LeoAndGit/dSIB_daVinci_setup_joint_interface_board/PCB/daVinciBoard-01.pdf

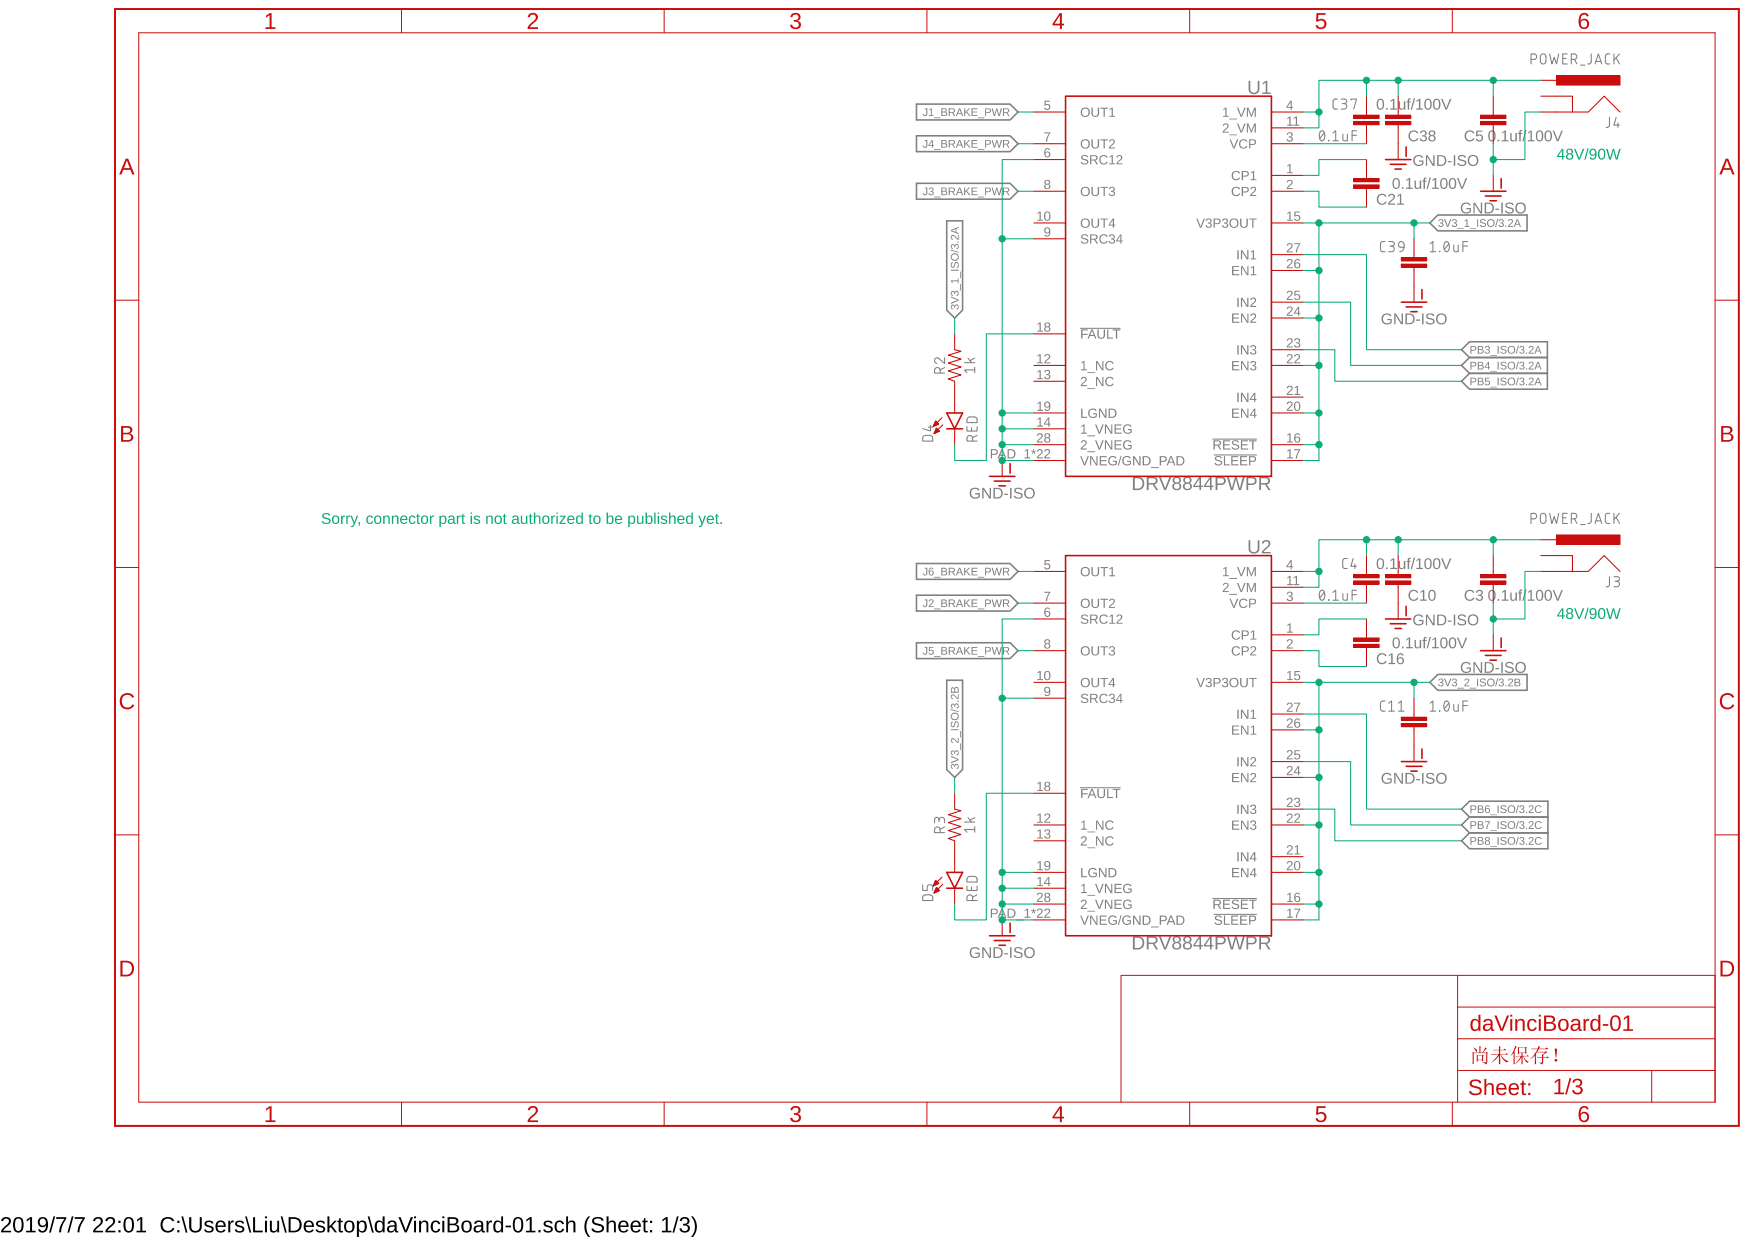
[picture p5: page 1]

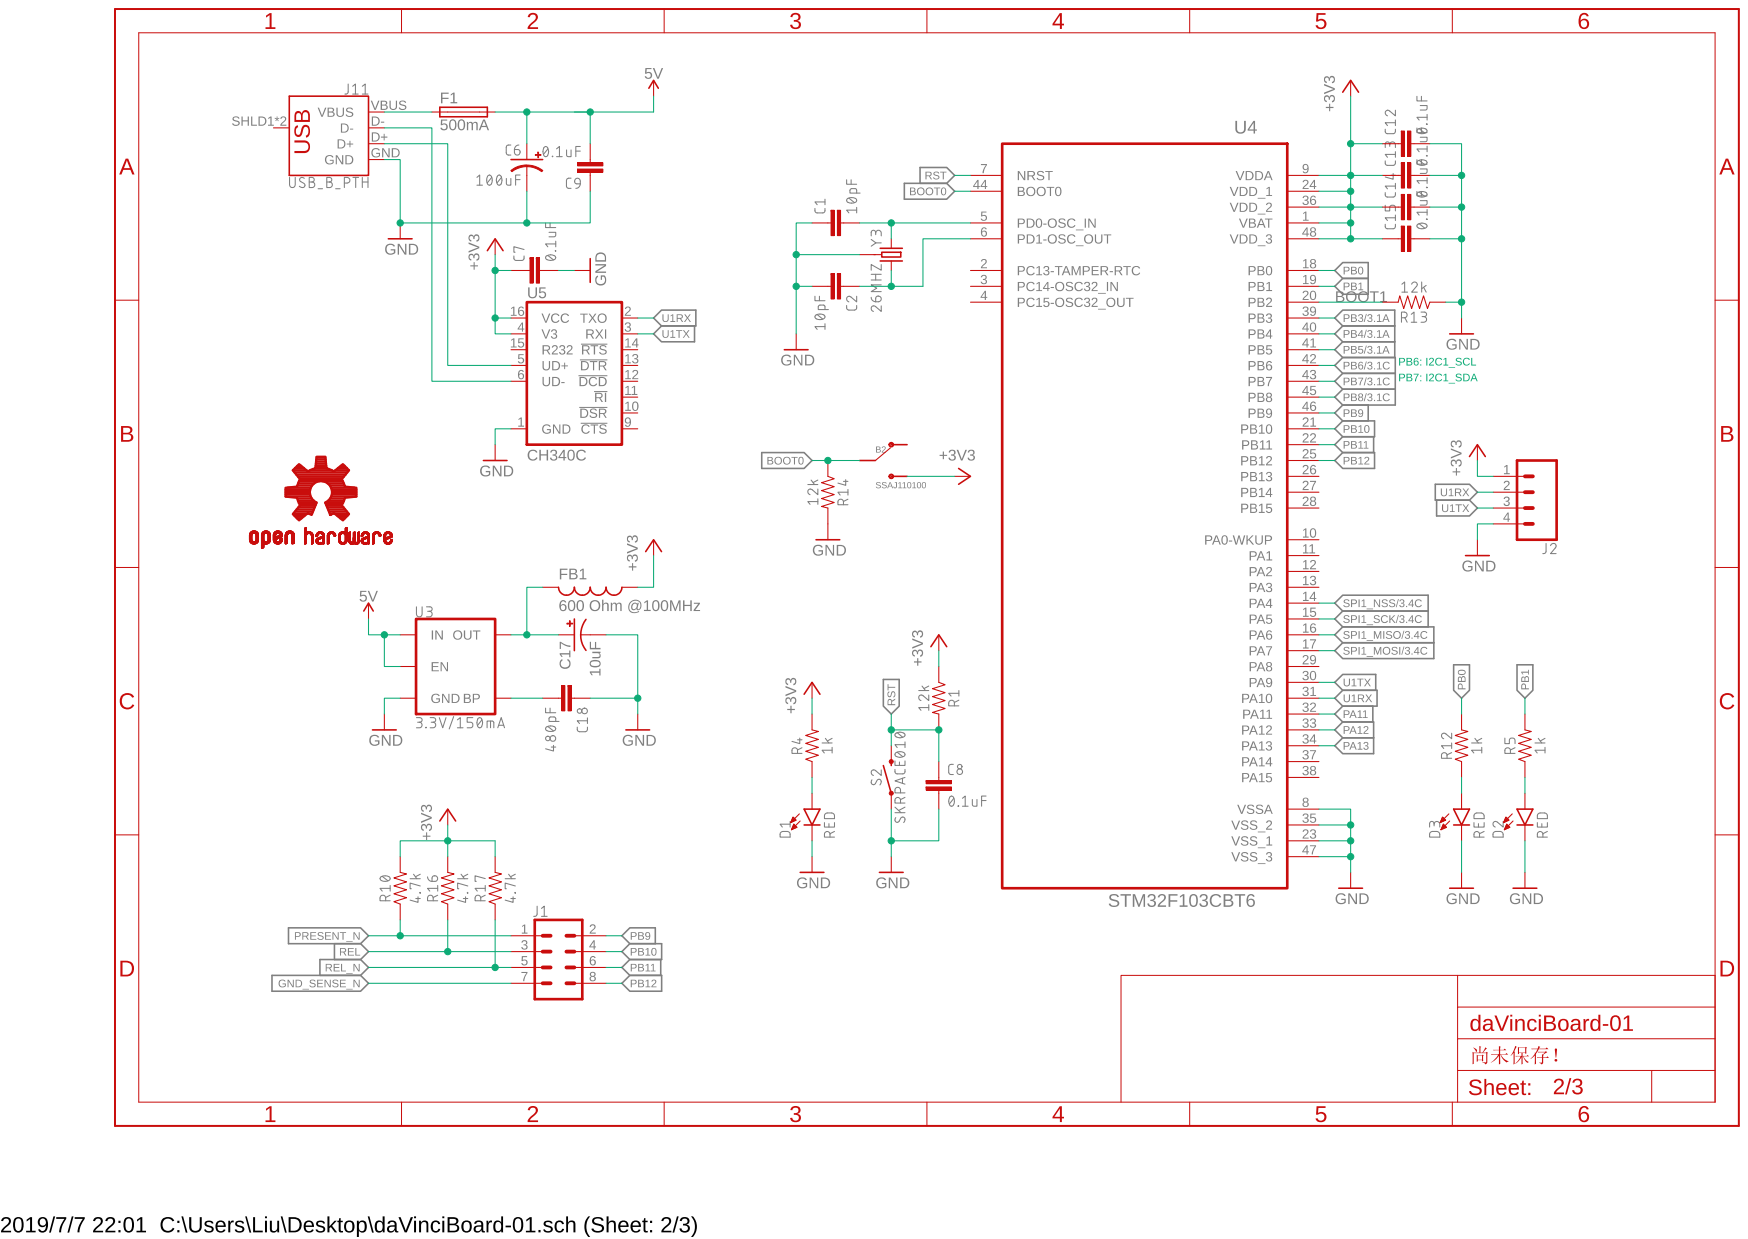
[picture p6: page 2]

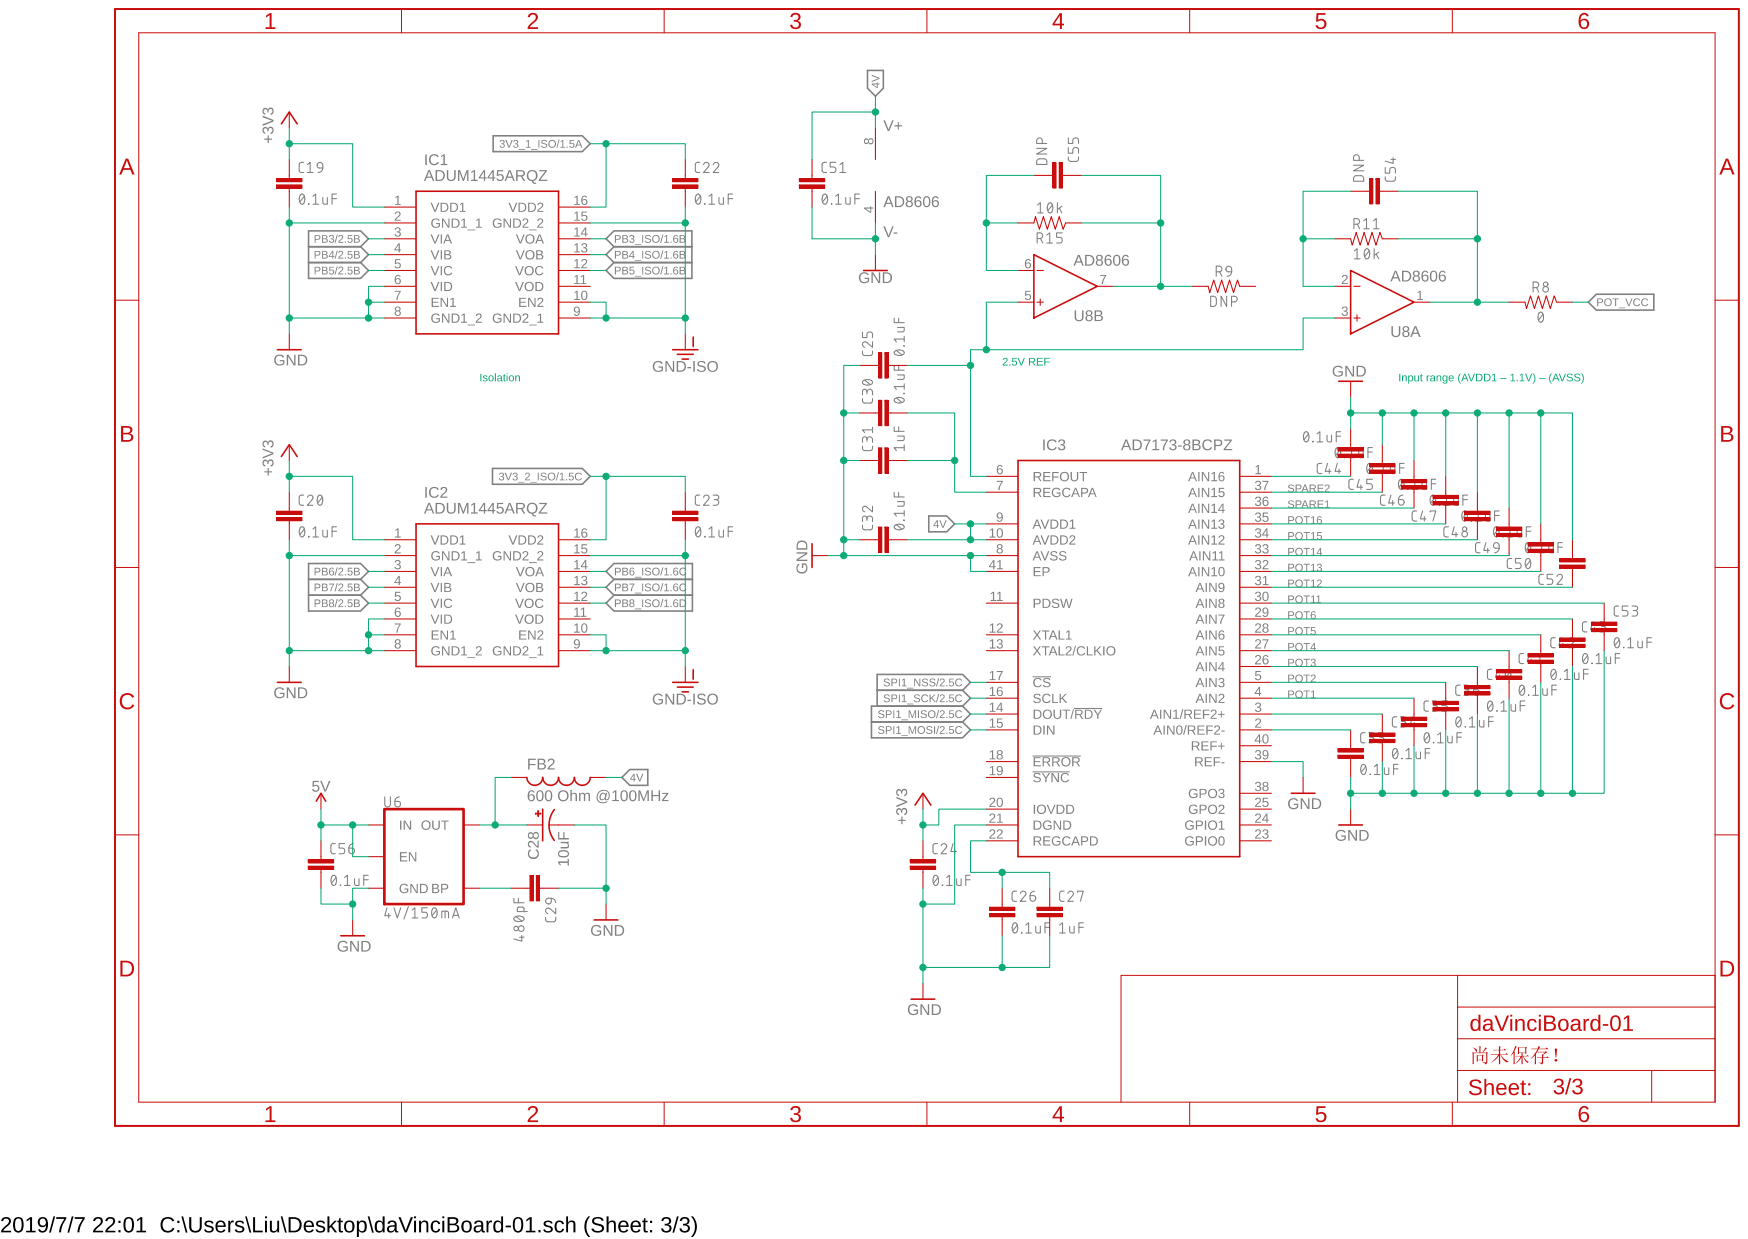
[picture p7: page 3]
