LeoAndGit/dSIB_daVinci_setup_joint_interface_board/code/python/mainUI.py

# -*- coding: utf-8 -*-

# Form implementation generated from reading ui file 'mainUI.ui'
#
# Created by: PyQt5 UI code generator 5.9.2
#
# WARNING! All changes made in this file will be lost!

from PyQt5 import QtCore, QtGui, QtWidgets

class Ui_Form(object):
    def setupUi(self, Form):
        Form.setObjectName("Form")
        Form.setEnabled(True)
        Form.resize(678, 595)
        Form.setContextMenuPolicy(QtCore.Qt.DefaultContextMenu)
        self.horizontalLayout_3 = QtWidgets.QHBoxLayout(Form)
        self.horizontalLayout_3.setObjectName("horizontalLayout_3")
        self.verticalLayout = QtWidgets.QVBoxLayout()
        self.verticalLayout.setObjectName("verticalLayout")
        self.horizontalLayout = QtWidgets.QHBoxLayout()
        self.horizontalLayout.setObjectName("horizontalLayout")
        self.link = QtWidgets.QPushButton(Form)
        sizePolicy = QtWidgets.QSizePolicy(QtWidgets.QSizePolicy.Minimum, QtWidgets.QSizePolicy.Minimum)
        sizePolicy.setHorizontalStretch(0)
        sizePolicy.setVerticalStretch(0)
        sizePolicy.setHeightForWidth(self.link.sizePolicy().hasHeightForWidth())
        self.link.setSizePolicy(sizePolicy)
        self.link.setObjectName("link")
        self.horizontalLayout.addWidget(self.link)
        self.start = QtWidgets.QPushButton(Form)
        sizePolicy = QtWidgets.QSizePolicy(QtWidgets.QSizePolicy.Minimum, QtWidgets.QSizePolicy.Minimum)
        sizePolicy.setHorizontalStretch(0)
        sizePolicy.setVerticalStretch(0)
        sizePolicy.setHeightForWidth(self.start.sizePolicy().hasHeightForWidth())
        self.start.setSizePolicy(sizePolicy)
        self.start.setObjectName("start")
        self.horizontalLayout.addWidget(self.start)
        self.stop = QtWidgets.QPushButton(Form)
        sizePolicy = QtWidgets.QSizePolicy(QtWidgets.QSizePolicy.Minimum, QtWidgets.QSizePolicy.Minimum)
        sizePolicy.setHorizontalStretch(0)
        sizePolicy.setVerticalStretch(0)
        sizePolicy.setHeightForWidth(self.stop.sizePolicy().hasHeightForWidth())
        self.stop.setSizePolicy(sizePolicy)
        self.stop.setStyleSheet("QPushButton { color: red }")
        self.stop.setObjectName("stop")
        self.horizontalLayout.addWidget(self.stop)
        self.verticalLayout.addLayout(self.horizontalLayout)
        self.textEdit = QtWidgets.QTextEdit(Form)
        self.textEdit.setEnabled(True)
        self.textEdit.setReadOnly(True)
        self.textEdit.setObjectName("textEdit")
        self.verticalLayout.addWidget(self.textEdit)
        self.verticalLayout.setStretch(0, 1)
        self.verticalLayout.setStretch(1, 6)
        self.horizontalLayout_3.addLayout(self.verticalLayout)
        self.verticalLayout_2 = QtWidgets.QVBoxLayout()
        self.verticalLayout_2.setObjectName("verticalLayout_2")
        self.gridLayout = QtWidgets.QGridLayout()
        self.gridLayout.setObjectName("gridLayout")
        self.lcdNumber_7 = QtWidgets.QLCDNumber(Form)
        self.lcdNumber_7.setObjectName("lcdNumber_7")
        self.gridLayout.addWidget(self.lcdNumber_7, 0, 2, 1, 1)
        self.label_4 = QtWidgets.QLabel(Form)
        self.label_4.setObjectName("label_4")
        self.gridLayout.addWidget(self.label_4, 2, 1, 1, 1)
        self.label_2 = QtWidgets.QLabel(Form)
        self.label_2.setObjectName("label_2")
        self.gridLayout.addWidget(self.label_2, 0, 3, 1, 1)
        self.label_10 = QtWidgets.QLabel(Form)
        self.label_10.setObjectName("label_10")
        self.gridLayout.addWidget(self.label_10, 3, 3, 1, 1)
        self.label_6 = QtWidgets.QLabel(Form)
        self.label_6.setObjectName("label_6")
        self.gridLayout.addWidget(self.label_6, 4, 1, 1, 1)
        self.label_9 = QtWidgets.QLabel(Form)
        self.label_9.setObjectName("label_9")
        self.gridLayout.addWidget(self.label_9, 2, 3, 1, 1)
        self.label_5 = QtWidgets.QLabel(Form)
        self.label_5.setObjectName("label_5")
        self.gridLayout.addWidget(self.label_5, 3, 1, 1, 1)
        self.label_11 = QtWidgets.QLabel(Form)
        self.label_11.setObjectName("label_11")
        self.gridLayout.addWidget(self.label_11, 4, 3, 1, 1)
        self.label_8 = QtWidgets.QLabel(Form)
        self.label_8.setObjectName("label_8")
        self.gridLayout.addWidget(self.label_8, 1, 3, 1, 1)
        self.label_7 = QtWidgets.QLabel(Form)
        self.label_7.setObjectName("label_7")
        self.gridLayout.addWidget(self.label_7, 5, 1, 1, 1)
        self.label_12 = QtWidgets.QLabel(Form)
        self.label_12.setObjectName("label_12")
        self.gridLayout.addWidget(self.label_12, 5, 3, 1, 1)
        self.lcdNumber_9 = QtWidgets.QLCDNumber(Form)
        self.lcdNumber_9.setObjectName("lcdNumber_9")
        self.gridLayout.addWidget(self.lcdNumber_9, 2, 2, 1, 1)
        self.lcdNumber_6 = QtWidgets.QLCDNumber(Form)
        self.lcdNumber_6.setObjectName("lcdNumber_6")
        self.gridLayout.addWidget(self.lcdNumber_6, 5, 0, 1, 1)
        self.label_3 = QtWidgets.QLabel(Form)
        self.label_3.setObjectName("label_3")
        self.gridLayout.addWidget(self.label_3, 1, 1, 1, 1)
        self.lcdNumber_8 = QtWidgets.QLCDNumber(Form)
        self.lcdNumber_8.setObjectName("lcdNumber_8")
        self.gridLayout.addWidget(self.lcdNumber_8, 1, 2, 1, 1)
        self.lcdNumber_10 = QtWidgets.QLCDNumber(Form)
        self.lcdNumber_10.setObjectName("lcdNumber_10")
        self.gridLayout.addWidget(self.lcdNumber_10, 3, 2, 1, 1)
        self.lcdNumber_11 = QtWidgets.QLCDNumber(Form)
        self.lcdNumber_11.setObjectName("lcdNumber_11")
        self.gridLayout.addWidget(self.lcdNumber_11, 4, 2, 1, 1)
        self.lcdNumber_1 = QtWidgets.QLCDNumber(Form)
        self.lcdNumber_1.setObjectName("lcdNumber_1")
        self.gridLayout.addWidget(self.lcdNumber_1, 0, 0, 1, 1)
        self.lcdNumber_12 = QtWidgets.QLCDNumber(Form)
        self.lcdNumber_12.setObjectName("lcdNumber_12")
        self.gridLayout.addWidget(self.lcdNumber_12, 5, 2, 1, 1)
        self.label = QtWidgets.QLabel(Form)
        self.label.setObjectName("label")
        self.gridLayout.addWidget(self.label, 0, 1, 1, 1)
        self.lcdNumber_2 = QtWidgets.QLCDNumber(Form)
        self.lcdNumber_2.setObjectName("lcdNumber_2")
        self.gridLayout.addWidget(self.lcdNumber_2, 1, 0, 1, 1)
        self.lcdNumber_3 = QtWidgets.QLCDNumber(Form)
        self.lcdNumber_3.setObjectName("lcdNumber_3")
        self.gridLayout.addWidget(self.lcdNumber_3, 2, 0, 1, 1)
        self.lcdNumber_4 = QtWidgets.QLCDNumber(Form)
        self.lcdNumber_4.setObjectName("lcdNumber_4")
        self.gridLayout.addWidget(self.lcdNumber_4, 3, 0, 1, 1)
        self.lcdNumber_5 = QtWidgets.QLCDNumber(Form)
        self.lcdNumber_5.setObjectName("lcdNumber_5")
        self.gridLayout.addWidget(self.lcdNumber_5, 4, 0, 1, 1)
        spacerItem = QtWidgets.QSpacerItem(40, 20, QtWidgets.QSizePolicy.Expanding, QtWidgets.QSizePolicy.Minimum)
        self.gridLayout.addItem(spacerItem, 6, 0, 1, 1)
        spacerItem1 = QtWidgets.QSpacerItem(40, 20, QtWidgets.QSizePolicy.Expanding, QtWidgets.QSizePolicy.Minimum)
        self.gridLayout.addItem(spacerItem1, 6, 2, 1, 1)
        self.verticalLayout_2.addLayout(self.gridLayout)
        self.gridLayout_3 = QtWidgets.QGridLayout()
        self.gridLayout_3.setObjectName("gridLayout_3")
        self.pushButton_7 = QtWidgets.QPushButton(Form)
        sizePolicy = QtWidgets.QSizePolicy(QtWidgets.QSizePolicy.Minimum, QtWidgets.QSizePolicy.Preferred)
        sizePolicy.setHorizontalStretch(0)
        sizePolicy.setVerticalStretch(0)
        sizePolicy.setHeightForWidth(self.pushButton_7.sizePolicy().hasHeightForWidth())
        self.pushButton_7.setSizePolicy(sizePolicy)
        self.pushButton_7.setObjectName("pushButton_7")
        self.gridLayout_3.addWidget(self.pushButton_7, 2, 0, 1, 1)
        self.pushButton_4 = QtWidgets.QPushButton(Form)
        sizePolicy = QtWidgets.QSizePolicy(QtWidgets.QSizePolicy.Minimum, QtWidgets.QSizePolicy.Preferred)
        sizePolicy.setHorizontalStretch(0)
        sizePolicy.setVerticalStretch(0)
        sizePolicy.setHeightForWidth(self.pushButton_4.sizePolicy().hasHeightForWidth())
        self.pushButton_4.setSizePolicy(sizePolicy)
        self.pushButton_4.setObjectName("pushButton_4")
        self.gridLayout_3.addWidget(self.pushButton_4, 1, 0, 1, 1)
        self.pushButton_6 = QtWidgets.QPushButton(Form)
        sizePolicy = QtWidgets.QSizePolicy(QtWidgets.QSizePolicy.Minimum, QtWidgets.QSizePolicy.Preferred)
        sizePolicy.setHorizontalStretch(0)
        sizePolicy.setVerticalStretch(0)
        sizePolicy.setHeightForWidth(self.pushButton_6.sizePolicy().hasHeightForWidth())
        self.pushButton_6.setSizePolicy(sizePolicy)
        self.pushButton_6.setObjectName("pushButton_6")
        self.gridLayout_3.addWidget(self.pushButton_6, 1, 2, 1, 1)
        self.pushButton_1 = QtWidgets.QPushButton(Form)
        sizePolicy = QtWidgets.QSizePolicy(QtWidgets.QSizePolicy.Minimum, QtWidgets.QSizePolicy.Preferred)
        sizePolicy.setHorizontalStretch(0)
        sizePolicy.setVerticalStretch(0)
        sizePolicy.setHeightForWidth(self.pushButton_1.sizePolicy().hasHeightForWidth())
        self.pushButton_1.setSizePolicy(sizePolicy)
        self.pushButton_1.setObjectName("pushButton_1")
        self.gridLayout_3.addWidget(self.pushButton_1, 0, 0, 1, 1)
        self.pushButton_5 = QtWidgets.QPushButton(Form)
        sizePolicy = QtWidgets.QSizePolicy(QtWidgets.QSizePolicy.Minimum, QtWidgets.QSizePolicy.Preferred)
        sizePolicy.setHorizontalStretch(0)
        sizePolicy.setVerticalStretch(0)
        sizePolicy.setHeightForWidth(self.pushButton_5.sizePolicy().hasHeightForWidth())
        self.pushButton_5.setSizePolicy(sizePolicy)
        self.pushButton_5.setObjectName("pushButton_5")
        self.gridLayout_3.addWidget(self.pushButton_5, 1, 1, 1, 1)
        self.pushButton_3 = QtWidgets.QPushButton(Form)
        sizePolicy = QtWidgets.QSizePolicy(QtWidgets.QSizePolicy.Minimum, QtWidgets.QSizePolicy.Preferred)
        sizePolicy.setHorizontalStretch(0)
        sizePolicy.setVerticalStretch(0)
        sizePolicy.setHeightForWidth(self.pushButton_3.sizePolicy().hasHeightForWidth())
        self.pushButton_3.setSizePolicy(sizePolicy)
        self.pushButton_3.setObjectName("pushButton_3")
        self.gridLayout_3.addWidget(self.pushButton_3, 0, 2, 1, 1)
        self.pushButton_8 = QtWidgets.QPushButton(Form)
        sizePolicy = QtWidgets.QSizePolicy(QtWidgets.QSizePolicy.Minimum, QtWidgets.QSizePolicy.Preferred)
        sizePolicy.setHorizontalStretch(0)
        sizePolicy.setVerticalStretch(0)
        sizePolicy.setHeightForWidth(self.pushButton_8.sizePolicy().hasHeightForWidth())
        self.pushButton_8.setSizePolicy(sizePolicy)
        self.pushButton_8.setObjectName("pushButton_8")
        self.gridLayout_3.addWidget(self.pushButton_8, 2, 1, 1, 1)
        self.pushButton_2 = QtWidgets.QPushButton(Form)
        sizePolicy = QtWidgets.QSizePolicy(QtWidgets.QSizePolicy.Minimum, QtWidgets.QSizePolicy.Preferred)
        sizePolicy.setHorizontalStretch(0)
        sizePolicy.setVerticalStretch(0)
        sizePolicy.setHeightForWidth(self.pushButton_2.sizePolicy().hasHeightForWidth())
        self.pushButton_2.setSizePolicy(sizePolicy)
        self.pushButton_2.setObjectName("pushButton_2")
        self.gridLayout_3.addWidget(self.pushButton_2, 0, 1, 1, 1)
        self.pushButton_9 = QtWidgets.QPushButton(Form)
        sizePolicy = QtWidgets.QSizePolicy(QtWidgets.QSizePolicy.Minimum, QtWidgets.QSizePolicy.Preferred)
        sizePolicy.setHorizontalStretch(0)
        sizePolicy.setVerticalStretch(0)
        sizePolicy.setHeightForWidth(self.pushButton_9.sizePolicy().hasHeightForWidth())
        self.pushButton_9.setSizePolicy(sizePolicy)
        self.pushButton_9.setObjectName("pushButton_9")
        self.gridLayout_3.addWidget(self.pushButton_9, 2, 2, 1, 1)
        self.verticalLayout_2.addLayout(self.gridLayout_3)
        self.verticalLayout_2.setStretch(0, 2)
        self.verticalLayout_2.setStretch(1, 1)
        self.horizontalLayout_3.addLayout(self.verticalLayout_2)
        self.horizontalLayout_3.setStretch(0, 2)
        self.horizontalLayout_3.setStretch(1, 3)

        self.retranslateUi(Form)
        self.stop.clicked.connect(Form.stopSlot)
        self.start.clicked.connect(Form.startSlot)
        self.link.clicked.connect(Form.linkSlot)
        self.pushButton_1.clicked.connect(Form.buttonClicked)
        self.pushButton_2.clicked.connect(Form.buttonClicked)
        self.pushButton_3.clicked.connect(Form.buttonClicked)
        self.pushButton_4.clicked.connect(Form.buttonClicked)
        self.pushButton_5.clicked.connect(Form.buttonClicked)
        self.pushButton_6.clicked.connect(Form.buttonClicked)
        self.pushButton_7.clicked.connect(Form.buttonClicked)
        self.pushButton_8.clicked.connect(Form.buttonClicked)
        self.pushButton_9.clicked.connect(Form.buttonClicked)
        QtCore.QMetaObject.connectSlotsByName(Form)

    def retranslateUi(self, Form):
        _translate = QtCore.QCoreApplication.translate
        Form.setWindowTitle(_translate("Form", "Arduino_Simple_AT_Command"))
        self.link.setText(_translate("Form", "Link"))
        self.start.setText(_translate("Form", "Start"))
        self.stop.setText(_translate("Form", "Stop"))
        self.label_4.setText(_translate("Form", "POT3"))
        self.label_2.setText(_translate("Form", "POT11"))
        self.label_10.setText(_translate("Form", "POT14"))
        self.label_6.setText(_translate("Form", "POT5"))
        self.label_9.setText(_translate("Form", "POT13"))
        self.label_5.setText(_translate("Form", "POT4"))
        self.label_11.setText(_translate("Form", "POT15"))
        self.label_8.setText(_translate("Form", "POT12"))
        self.label_7.setText(_translate("Form", "POT6"))
        self.label_12.setText(_translate("Form", "POT16"))
        self.label_3.setText(_translate("Form", "POT2"))
        self.label.setText(_translate("Form", "POT1"))
        self.pushButton_7.setText(_translate("Form", "ReleaseJ4"))
        self.pushButton_4.setText(_translate("Form", "ReleaseJ1"))
        self.pushButton_6.setText(_translate("Form", "ReleaseJ3"))
        self.pushButton_1.setText(_translate("Form", "ReleaseAll"))
        self.pushButton_5.setText(_translate("Form", "ReleaseJ2"))
        self.pushButton_3.setText(_translate("Form", "AT"))
        self.pushButton_8.setText(_translate("Form", "ReleaseJ5"))
        self.pushButton_2.setText(_translate("Form", "LockAll"))
        self.pushButton_9.setText(_translate("Form", "ReleaseJ6"))
